HarrydeBug/CW_Flea/Hardware/BOM_PCB_CW Flea 1.3_2022-06-02.csv

ID | Name | Designator | Footprint | Quantity | Manufacturer Part | Manufacturer | Supplier | Supplier Part | Price
1 | 560nH | L4 | L1812 | 1 | FHW1812IFR56JST | Guangdong Fenghua Advanced Tech | LCSC | C394109 | 0.097
2 | 1uH | L1 | IND-SMD_L4.8-W3.4 | 1 | FHW1812IF1R0JST | Guangdong Fenghua Advanced Tech | LCSC | C394110 | 0.13
3 | 470nH | L5,L6 | IND-SMD_L3.2-W2.5 | 2 | NLCV32T-R47M-EFR | TDK | LCSC | C295222 | 0.142
4 | DOSIN-801-0050 | ANTENNA | BNC-TH_DOSIN-801-0051 | 1 | DOSIN-801-0050 | dosinconn | LCSC | C521210 | 0.584
5 | CH340C | U9 | SOP-16_L10.0-W3.9-P1.27-LS6.0-BL | 1 | CH340C | WCH | LCSC | C84681 | 0.443
6 | 150pF | C25 | C0805 | 1 | 0805B151K500NT | FH | LCSC | C1716 | 0.006
7 | 560pF | C26,C7 | C0805 | 2 | CC0805JRNPO9BN561 | YAGEO | LCSC | C107119 | 0.012
8 | 10K | R15,R18,R19,R4,R5 | R0805 | 5 | 0805W8F1002T5E | UniOhm | LCSC | C17414 | 0.002
9 | SM4007PL | D5,D6,D1,D2,D3,D4 | SOD-123F_L2.8-W1.8-LS3.7-RD | 6 | SM4007PL | MDD | LCSC | C64898 | 0.008
10 | 470pF | C8 | C0805 | 1 | 0805N471J500 | Huaxin S&T | LCSC | C163163 | 0.008
11 | 330pF | C9 | C0805 | 1 | CC0805JRNPO0BN331 | YAGEO | LCSC | C113820 | 0.009
12 | 390pF | C10 | C0805 | 1 | 0805CG391J500NT | FH | LCSC | C1818 | 0.014
13 | 120pF | C14,C15 | C0805 | 2 | CC0805JRNPO9BN121 | YAGEO | LCSC | C107109 | 0.014
14 | 220pF | C16,C11,C12 | C0805 | 3 | CC0805JRNPO0BN221 | YAGEO | LCSC | C113819 | 0.009
15 | 39pF | C17 | C0805 | 1 | 0805N390J500CT | Huaxin S&T | LCSC | C296098 | 0.008
16 | 82pF | C18 | C0805 | 1 | CC0805JRNPO9BN820 | YAGEO | LCSC | C113833 | 0.007
17 | 56pF | C20 | C0805 | 1 | CC0805JRNPO0BN560 | YAGEO | LCSC | C113822 | 0.011
18 | TLC-NSMD025 | U4,U5 | R1206 | 2 | TLC-NSMD025 | TLC Electronic | LCSC | C261950 | 0.046
19 | 321006SG0ABK00A01 | CN1 | IDC-TH_321006SG0ABK00A01 | 1 | 321006SG0ABK00A01 | JILN | LCSC | C601936 | 0.07
20 | 22uF | C1,C3,C4,C5,C19 | C0805 | 5 | CL21A226MAQNNNE | SAMSUNG | LCSC | C45783
21 | 100nF | C2,C6,C23,C24 | C0805 | 4 | CL21B104KCFNNNE | SAMSUNG | LCSC | C28233 | 0.009
22 | 270pF | C13 | C0805 | 1 | 0805N271J500 | WTC | LCSC | C123644 | 0.011
23 | 12 DC in | DC1 | DC-IN-TH_DC005 | 1 | DC-005-25A | HRO | LCSC | C136715 | 0.116
24 | HFD4/5-S_C425975 | K1,K2 | RELAY-SMD_HFD4-5-S | 2 | HFD4/5-S | Xiamen Hongfa Electroacoustic | LCSC | C425975 | 0.975
25 | 820nH | L2,L3 | IND-SMD_L2.9-W2.8 | 2 | AISC-1008-R82J-T | Abracon LLC | LCSC | C187057 | 0.264
26 | MMBT3904 | Q1,Q2 | SOT-23-3_L2.9-W1.3-P1.90-LS2.4-BR | 2 | MMBT3904 | CJ | LCSC | C20526 | 0.014
27 | 1K | R1,R2,R3,R9,R10,R13,R14,R16,R17 | R0805 | 9 | 0805W8F1001T5E | UniOhm | LCSC | C17513 | 0.002
28 | 2.2K | R6,R7,R8 | R0805 | 3 | 0805W8F2201T5E | UniOhm | LCSC | C17520 | 0.002
29 | 1M | R11 | R0603 | 1 | 0603WAF1004T5E | UniOhm | LCSC | C22935 | 0.001
30 | To Receiver | SMA | SMA-TH_HJ-SMA003 | 1 | HJ-SMA003 | 皇捷 | LCSC | C1509227 | 0.677
31 | Band | SW1 | KEY-TH_4P-L7.5-W6.8-P4.50-LS7.2 | 1 | TS-1002NT-26 | XUNPU | LCSC | C455197 | 0.054
32 | Tune Down | SW2 | KEY-TH_4P-L7.5-W6.8-P4.50-LS7.2 | 1 | TS-1002NT-26 | XUNPU | LCSC | C455197 | 0.054
33 | Tune Up | SW3 | KEY-TH_4P-L7.5-W6.8-P4.50-LS7.2 | 1 | TS-1002NT-26 | XUNPU | LCSC | C455197 | 0.054
34 | KT-0603R | TX | LED0603-R-RD | 1 | KT-0603R | KENTO | LCSC | C2286
35 | MS5351M | U1 | MSOP-10_L3.0-W3.0-P0.50-LS5.0-BL | 1 | MS5351M | 杭州瑞盟 | LCSC | C1509083 | 1.128
36 | ATMEGA328P-AU | U2 | TQFP-32_L7.0-W7.0-P0.80-LS9.0-BL | 1 | ATMEGA328P-AU | MICROCHIP | LCSC | C14877 | 32.641
37 | SN74HC244PWR | U3,U7 | TSSOP-20_L6.5-W4.4-P0.65-LS6.4-BL | 2 | SN74HC244PWR | TI | LCSC | C6835 | 0.286
38 | XC6206P332MR | U8 | SOT-23-3_L2.9-W1.6-P1.90-LS2.8-BR | 1 | XC6206P332MR | TOREX | LCSC | C5446 | 0.135
39 | CJ78M05_C9070 | U10 | TO-252-3_L6.5-W5.8-P4.58-TL | 1 | CJ78M05 | CJ | LCSC | C9070 | 0.118
40 | U-F-M5DD-Y-L | USB1 | MICRO-USB-SMD_MICRO-USB-18 | 1 | U-F-M5DD-Y-L | HRO | LCSC | C91146 | 0.113
41 | 26MHz | X1 | OSC-SMD_4P-L2.5-W2.0-BL | 1 | 1XXB26000MAA | KDS | LCSC | C132296 | 1.139
42 | 8MHz | X2 | OSC-SMD_L5.0-W3.2 | 1 | X50328MSB2GI | YXC | LCSC | C115962 | 0.191
43 | 20m | 20M | LED0805-RD_GREEN | 1 | 0805G (Green) | KENTO | LCSC | C2297
44 | 30m | 30M | LED0805-RD_GREEN | 1 | 0805G (Green) | KENTO | LCSC | C2297
45 | 40m | 40M | LED0805-RD_GREEN | 1 | 0805G (Green) | KENTO | LCSC | C2297
46 | Key | AUDIO1 | AUDIO-SMD_PJ-313D | 1 | PJ-313D | HRO | LCSC | C95463 | 0.098
