HarrydeBug/CW_Flea/Hardware/Schematic_CW Flea Version 1.3_2022-06-02.pdf

## 5.6V to PA5.6V

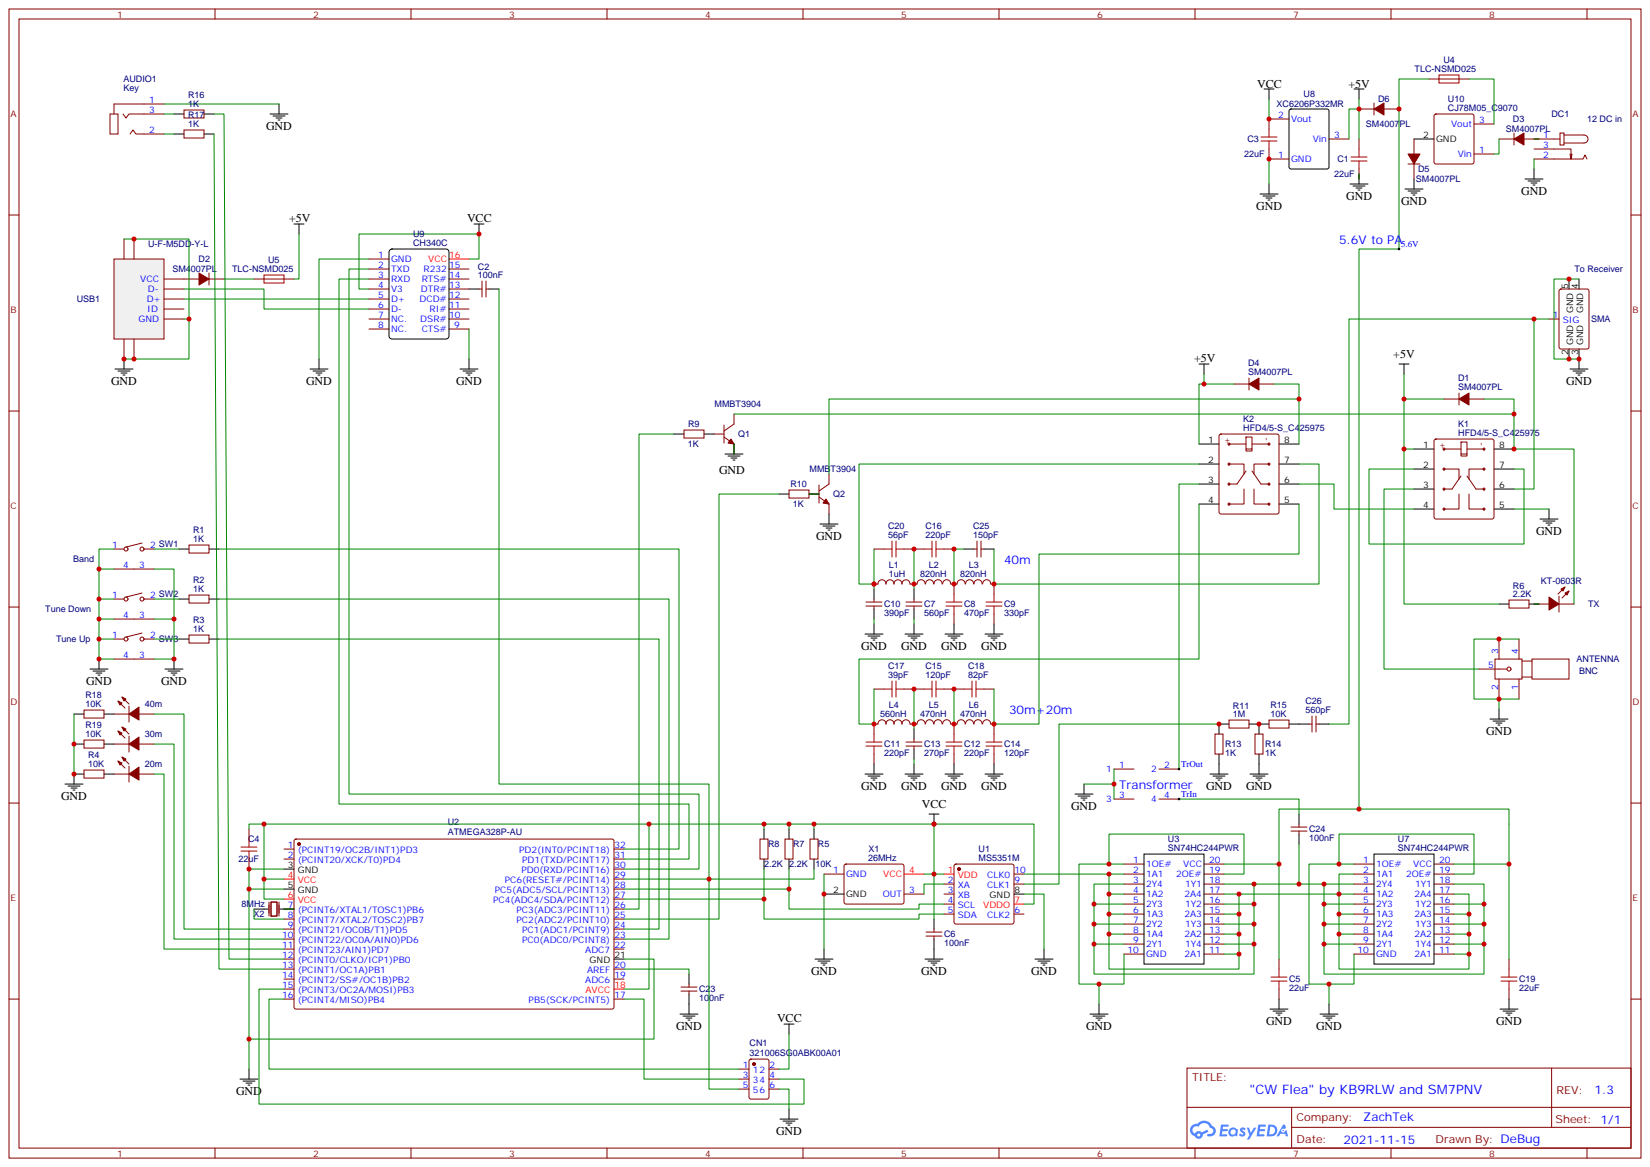
[picture p1: page 1]
