HarrydeBug/CW_Flea/(commit log)

2022-04-06 Arduino Software
2022-06-02 Changed the Up/Down buttons
    The Up/Down buttons had been flipped from Hardware Version 2 (This software is for Hardware Revision 3)
    [HWR3_Ver1.5.ino]
2022-06-02 Schema, BOM and Gerbers
    [BOM_PCB_CW Flea 1.3_2022-06-02.csv]
2022-06-02 Arduino Code. Set board to Arduino Pro Mini 8MHz
2022-06-02 Arduino code. Set board to : Arduino Pro Mini 8MHz
