HarrydeBug/CW_Flea/(notices)

Notices in the files:
Software/HWR2_Ver1.5.1/HWR2_Ver1.5.1.ino:
under the terms of the GNU General Public License as published by the
Free Software Foundation.
